shawnchain/MicroAPRS/Design/Eagle.smd/Modem.brd

## EAGLE design Design/Eagle.smd/Modem.brd (2014-09-27)

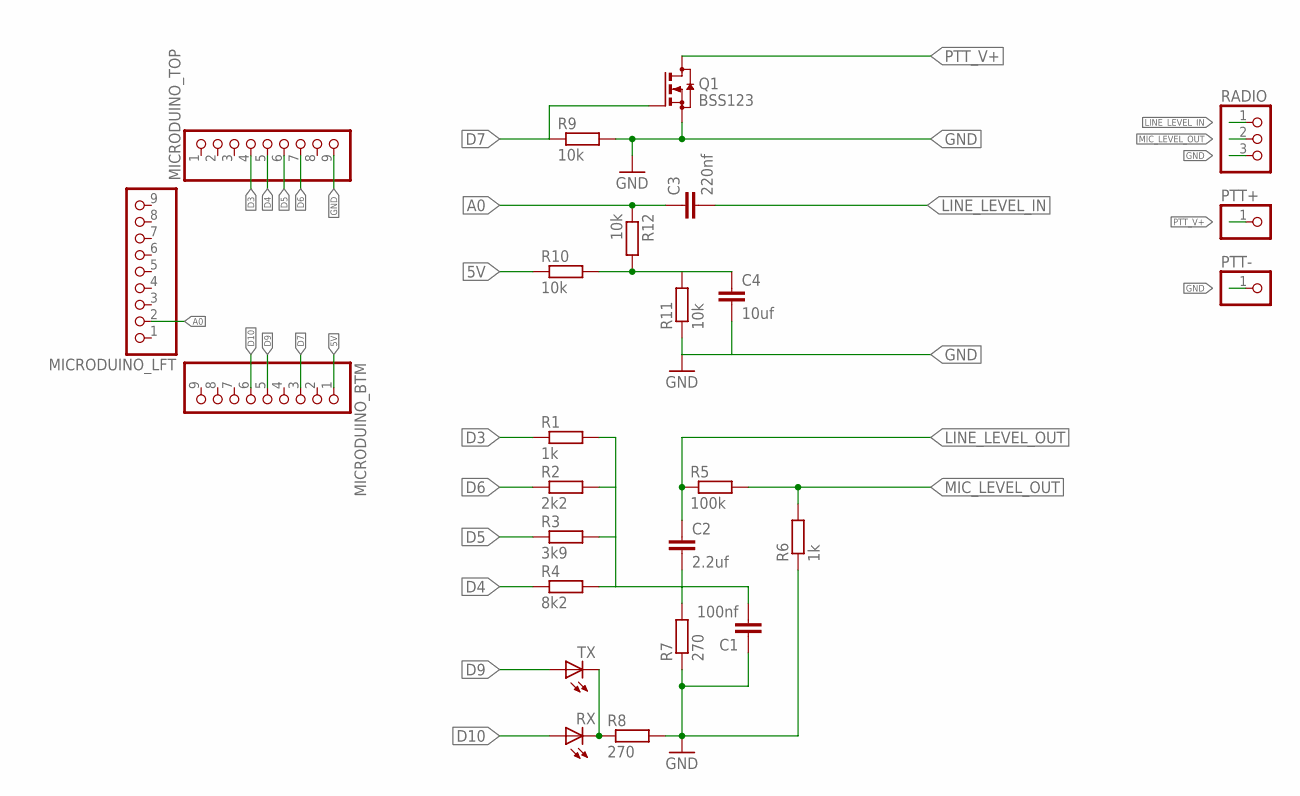
[picture p1: schematic Modem.sch]

Parts:
C1: 100nf; C0603
C2: 2.2uf; C1206
C3: 220nf; C0603
C4: 10uf; C1206
MICRODUINO_BTM: PINHD-1X9; 1X09-BIG
MICRODUINO_LFT: PINHD-1X9; 1X09-BIG
MICRODUINO_TOP: PINHD-1X9; 1X09-BIG
PTT+: PINHD-1X1; 1X01
PTT-: PINHD-1X1; 1X01
Q1: BSS123; SOT23
R1, R6: 1k; R0603
R2: 2k2; R0603
R3: 3k9; R0603
R4: 8k2; R0603
R5: 100k; R0603
R7, R8: 270; R0603
R9, R10, R11, R12: 10k; R0603
RADIO: PINHD-1X3; 1X03
RX: LED_E; LED_1206
TX: LED_E; LED_1206

Connections:
5V: MICRODUINO_BTM.1, R10.1
A0: C3.1, MICRODUINO_LFT.2, R12.1
D3: MICRODUINO_TOP.4, R1.1
D4: MICRODUINO_TOP.5, R4.1
D5: MICRODUINO_TOP.6, R3.1
D6: MICRODUINO_TOP.7, R2.1
D7: MICRODUINO_BTM.3, Q1.1 (G), R9.1
D9: MICRODUINO_BTM.5, TX.A
D10: MICRODUINO_BTM.6, RX.A
GND: C1.1, C4.2, MICRODUINO_TOP.9, PTT-.1, Q1.2 (S), R6.1, R7.1, R8.2, R9.2, R11.1, RADIO.3
LINE_LEVEL_IN: C3.2, RADIO.1
LINE_LEVEL_OUT: C2.1, R5.1
MIC_LEVEL_OUT: R5.2, R6.2, RADIO.2
unnamed: R8.1, RX.C, TX.C
unnamed: C1.2, C2.2, R1.2, R2.2, R3.2, R4.2, R7.2
unnamed: C4.1, R10.2, R11.2, R12.2
PTT_V+: PTT+.1, Q1.3 (D)

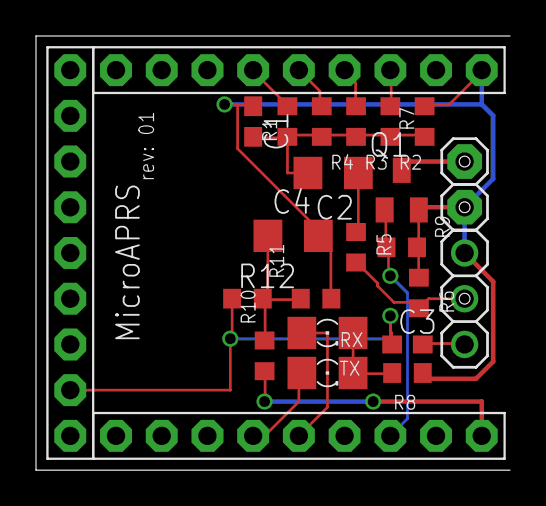
[picture p2: board Modem.brd from above]

Board: 2 copper layers, 26.3 x 24.1 mm, 25 parts (0 on the bottom side), 17 nets.
