shawnchain/MicroAPRS/Modem/protocol/SimpleSerial.h

#ifndef PROTOCOL_SIMPLE_SERIAL
#include <net/ax25.h>
#include <drv/ser.h>

#define PROTOCOL_SIMPLE_SERIAL 0x01

#define DEFAULT_CALLSIGN "NOCALL"
#define DEFAULT_DESTINATION_CALL "BG5HHP"

void ss_init(AX25Ctx *ax25, Serial *ser);

void ss_messageCallback(struct AX25Msg *msg, Serial *ser);
void ss_serialCallback(void *_buffer, size_t length, Serial *ser, AX25Ctx *ctx);

void ss_sendPkt(void *_buffer, size_t length, AX25Ctx *ax25);
void ss_sendLoc(void *_buffer, size_t length, AX25Ctx *ax25);
void ss_sendMsg(void *_buffer, size_t length, AX25Ctx *ax25);
void ss_msgRetry(AX25Ctx *ax25);

void ss_clearSettings(void);
void ss_loadSettings(void);
void ss_saveSettings(void);
void ss_printSettings(void);

void ss_printHelp(void);

#endif
