shawnchain/MicroAPRS/(commit log)

2014-09-21 Add FIR filter
2014-09-23 Remove MODEM_DEBUG to slim down the hex size so that to run under ArduinoProMini
2014-09-27 Change PCB design to use SMD
    [Modem.brd, Modem.sch]
2014-09-27 Add input filter
    [Modem.brd, Modem.sch]
